db-electronics/UMDv3-kicad/(notices)

Notices in the files:
UMDv3/UMDv3.kicad_pcb:
Licensed Under CERN OHL v.1.2
UMDv3/UMDv3.kicad_sch:
Copyright 2024 René Richard
